welbertdeoliveira/Detector-de-condutividade-termica--TCD--para-cromatografia-a-gas/Diagramas mecanicos/DIAGRAMA BASICO.pptx

AMOSTRA

INJETOR

GÁS DE REFERÊNCIA

GÁS DE
ARRASTE

TCD

DESCARTE

SINAL

COLUNA

FORNO

FONTE DE GÁS

= Áreas aquecidas.

## Slide 2

PID

ATUADOR

FORNO

TEMPERATURA
DESEJADA

+

TEMPERATURA
AJUSTADA

SENSOR

SET POINT

VALOR
DESEJADO

AÇÃO P

ATUADOR

VARIAVEL
MANIPULADA

PROCESSO

VARIAVEL DE
PROCESSO

+

ERRO

AÇÃO I

+

+

+

VALOR
AJUSTADO

AÇÃO D

SENSOR
