welbertdeoliveira/Detector-de-condutividade-termica--TCD--para-cromatografia-a-gas/Fotos/20191212_202534.jpg

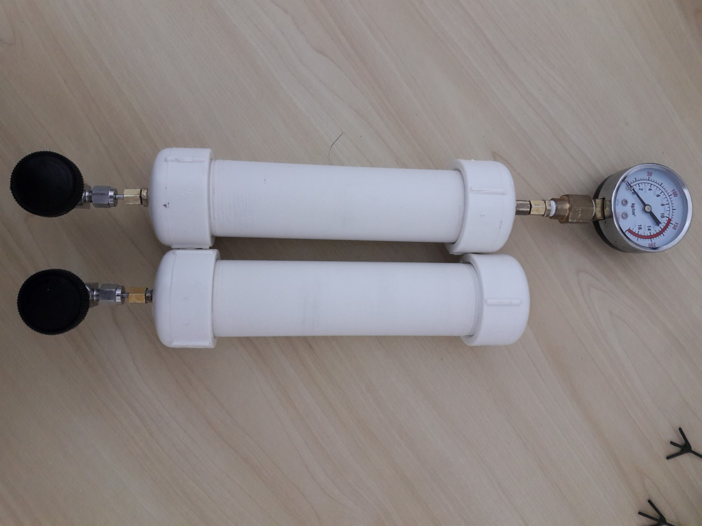
Fotos/20191212_202534.jpg
