welbertdeoliveira/Detector-de-condutividade-termica--TCD--para-cromatografia-a-gas/Fotos/20200205_210533.jpg

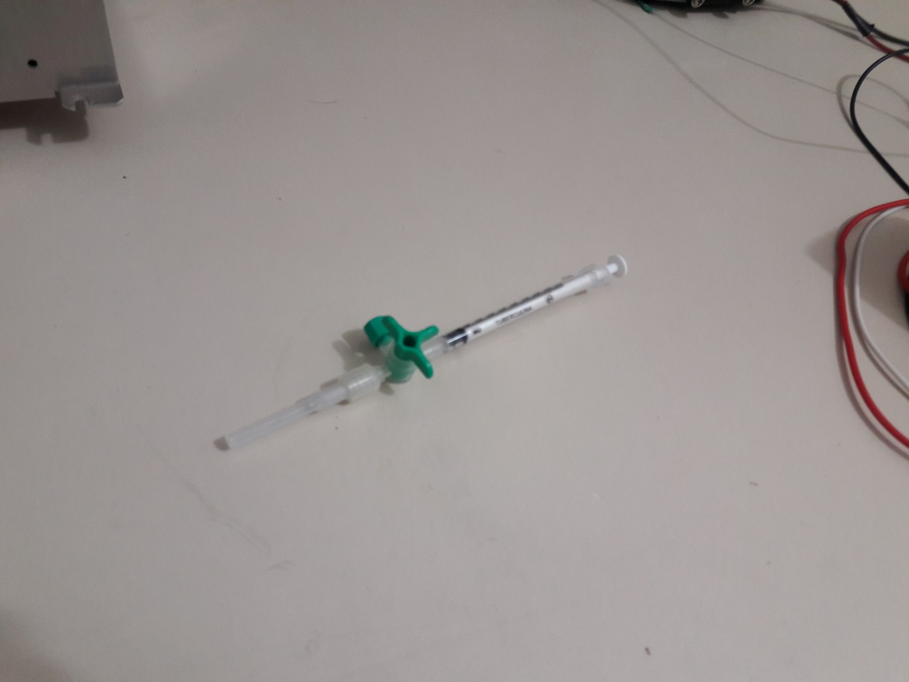
Fotos/20200205_210533.jpg
