welbertdeoliveira/Detector-de-condutividade-termica--TCD--para-cromatografia-a-gas/Fotos/20200209_221522.jpg

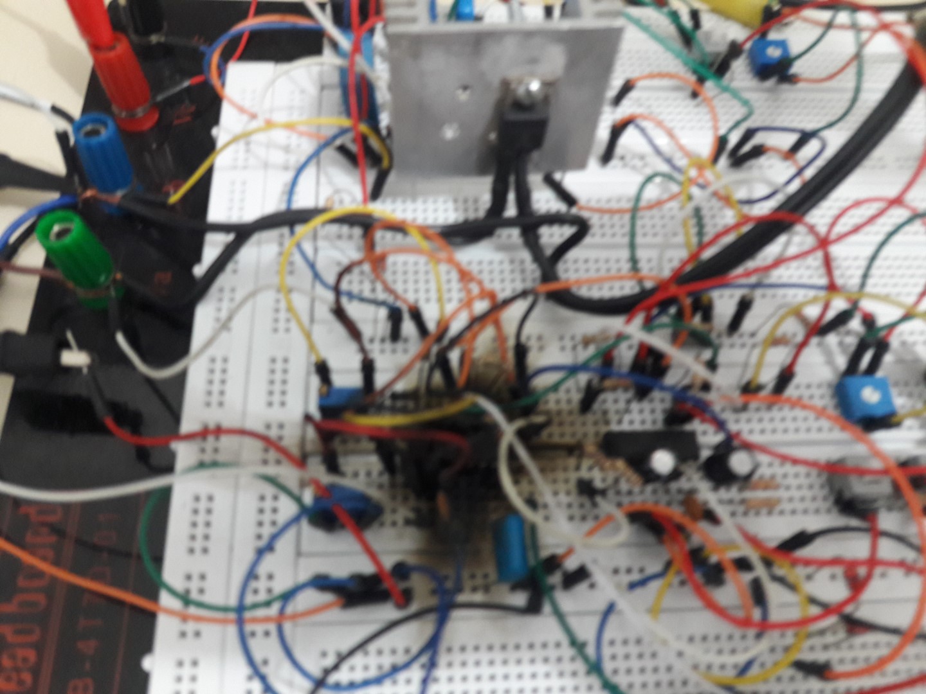
Fotos/20200209_221522.jpg
