welbertdeoliveira/Detector-de-condutividade-termica--TCD--para-cromatografia-a-gas/Fotos/20200209_230001.jpg

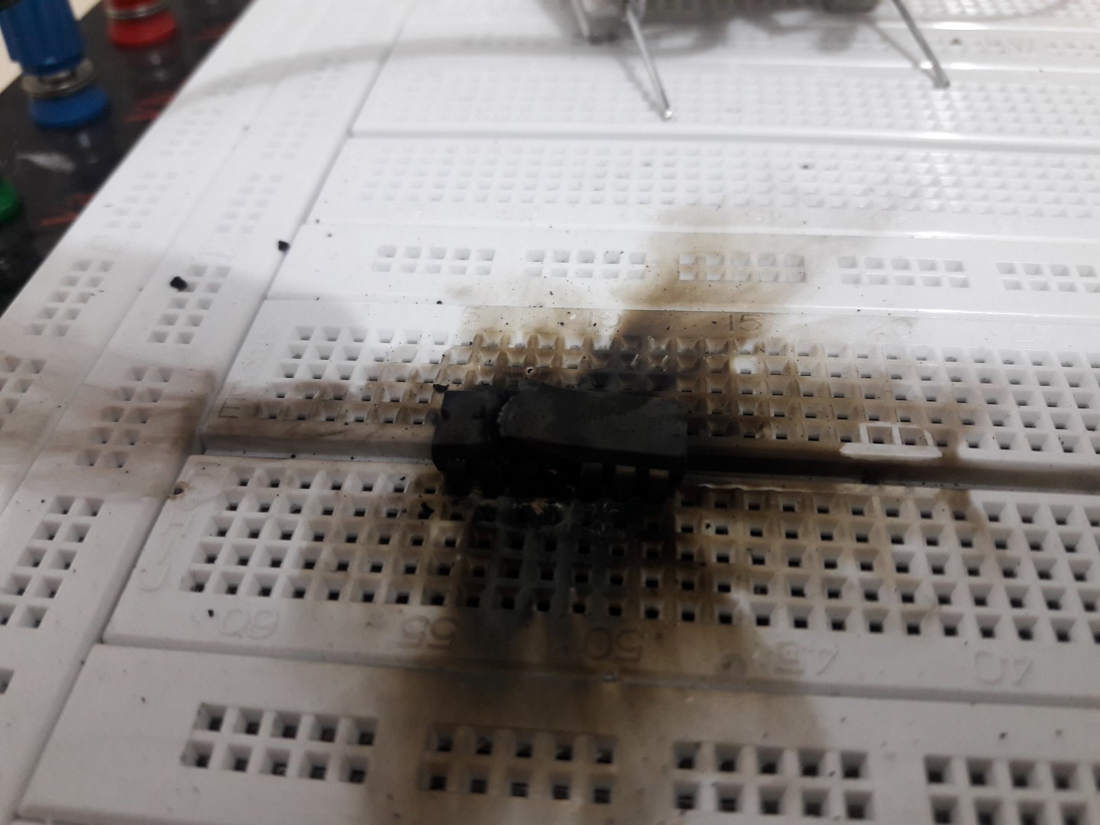
Fotos/20200209_230001.jpg
