welbertdeoliveira/Detector-de-condutividade-termica--TCD--para-cromatografia-a-gas/Fotos/20200210_165037.jpg

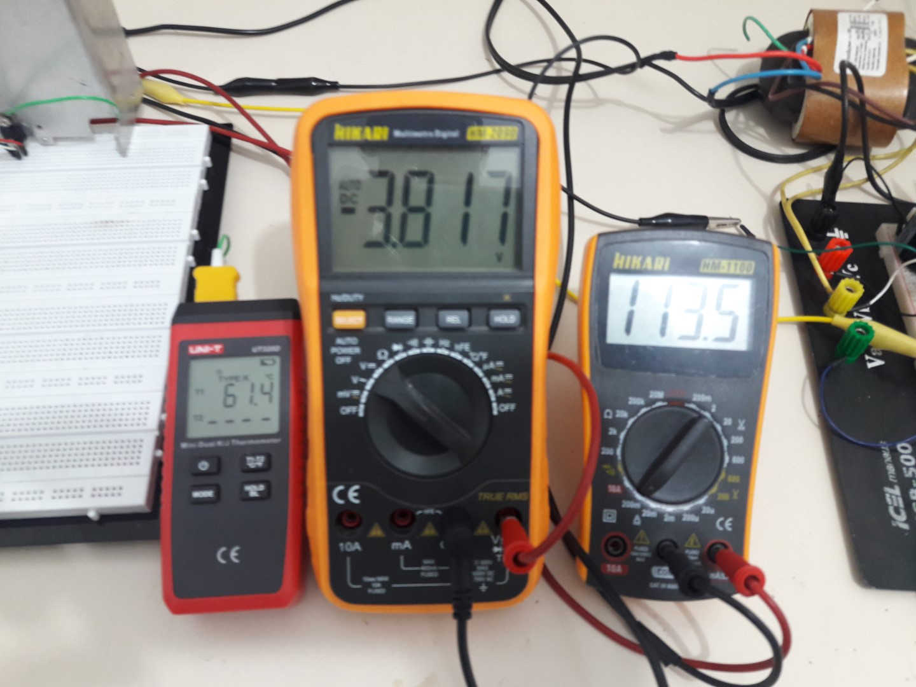
Fotos/20200210_165037.jpg
