welbertdeoliveira/Detector-de-condutividade-termica--TCD--para-cromatografia-a-gas/Fotos/20200210_211105.jpg

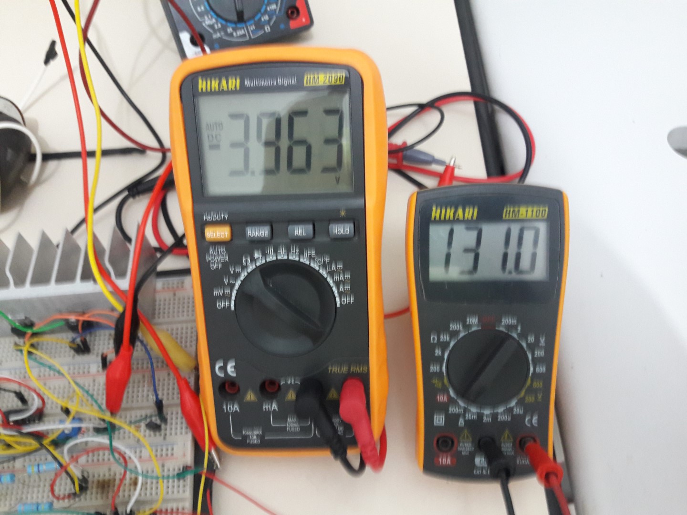
Fotos/20200210_211105.jpg
