welbertdeoliveira/Detector-de-condutividade-termica--TCD--para-cromatografia-a-gas/Fotos/20200210_211108.jpg

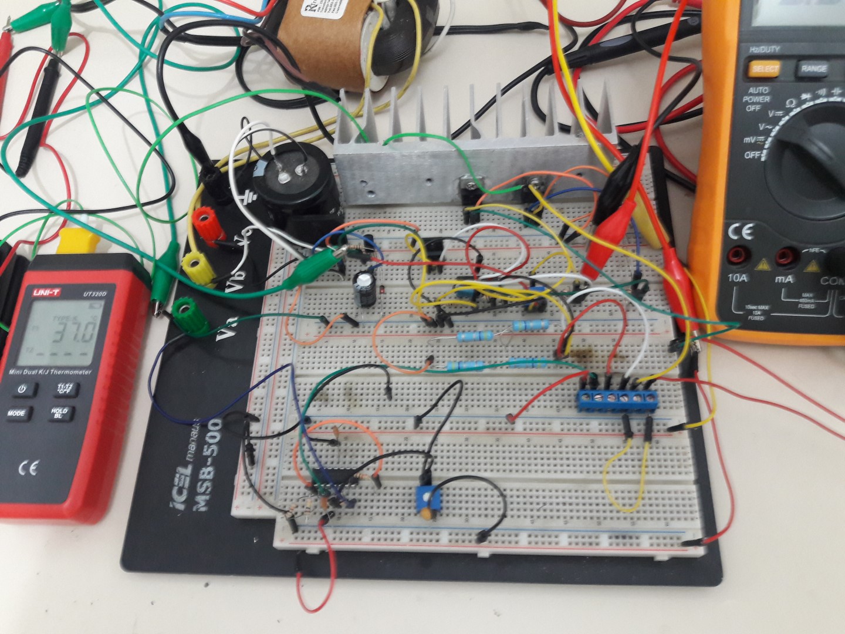
Fotos/20200210_211108.jpg
