welbertdeoliveira/Detector-de-condutividade-termica--TCD--para-cromatografia-a-gas/Fotos/20200213_203528.jpg

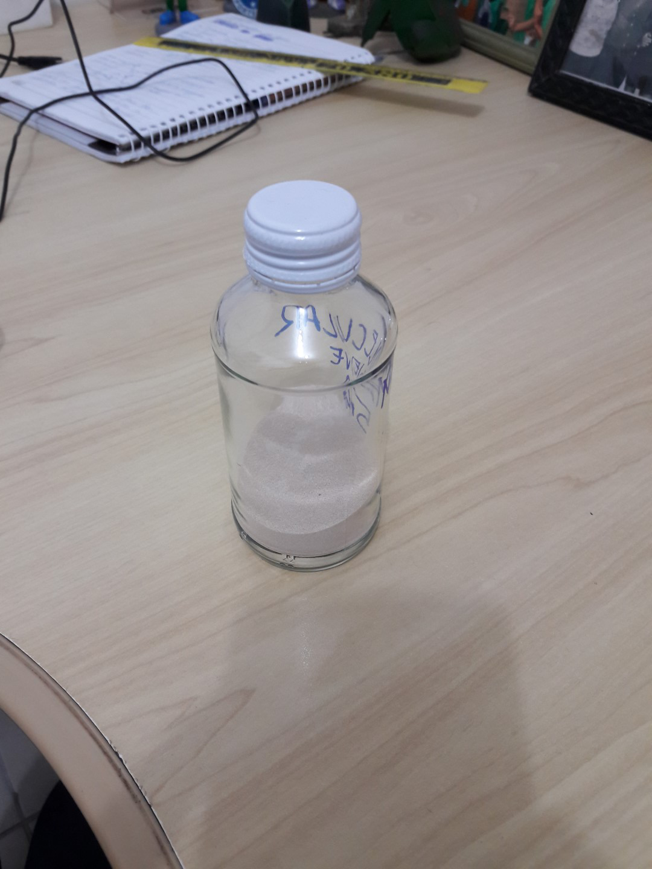
Fotos/20200213_203528.jpg
