welbertdeoliveira/Detector-de-condutividade-termica--TCD--para-cromatografia-a-gas/Fotos/20200216_193552.jpg

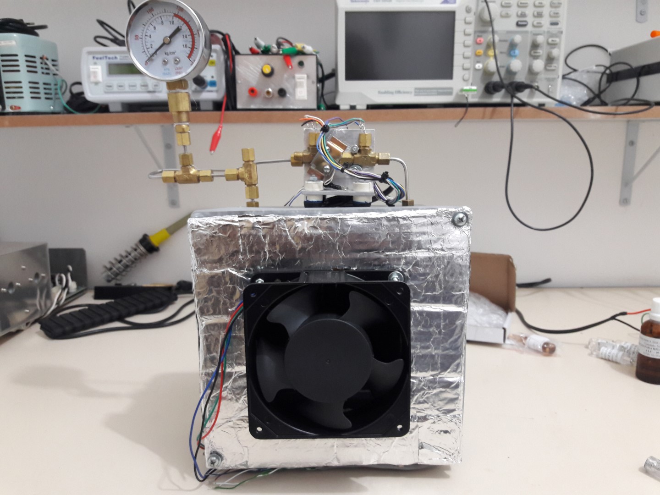
Fotos/20200216_193552.jpg
