welbertdeoliveira/Detector-de-condutividade-termica--TCD--para-cromatografia-a-gas/Fotos/20200216_193612.jpg

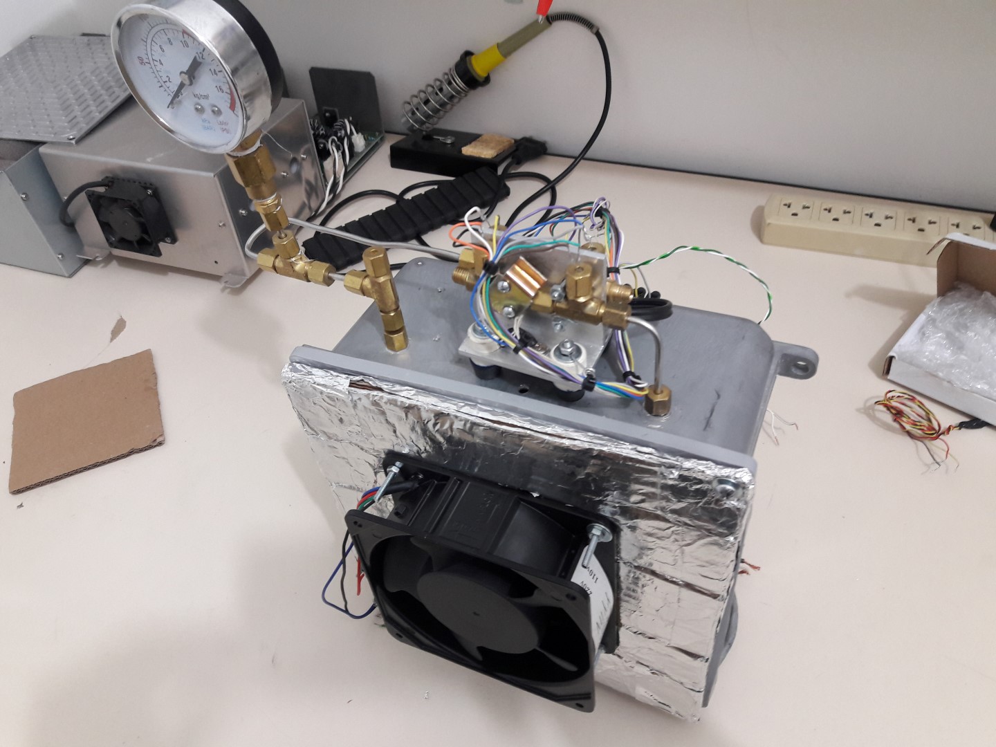
Fotos/20200216_193612.jpg
