welbertdeoliveira/Detector-de-condutividade-termica--TCD--para-cromatografia-a-gas/Fotos/Celula impressa/20200526_104427.jpg

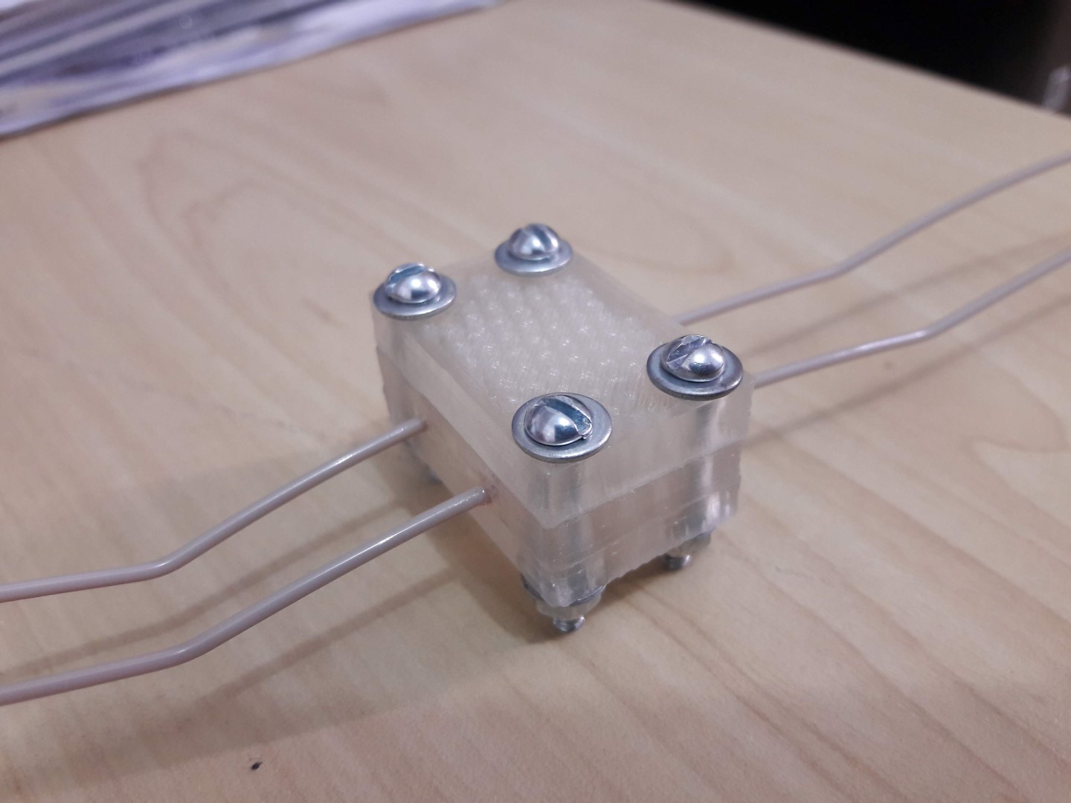
Fotos/Celula impressa/20200526_104427.jpg
