welbertdeoliveira/Detector-de-condutividade-termica--TCD--para-cromatografia-a-gas/Fotos/Célula nova/20191121_211144.jpg

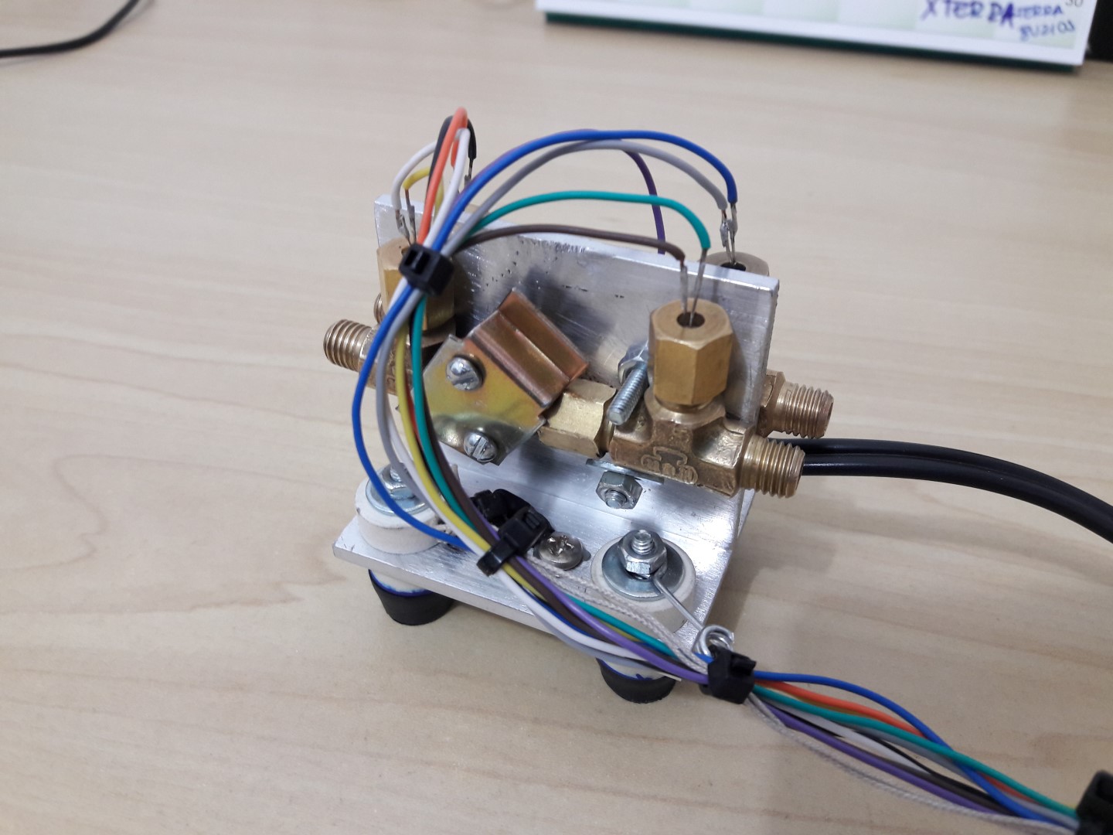
Fotos/Célula nova/20191121_211144.jpg
