welbertdeoliveira/Detector-de-condutividade-termica--TCD--para-cromatografia-a-gas/Fotos/Célula nova/20191121_211309.jpg

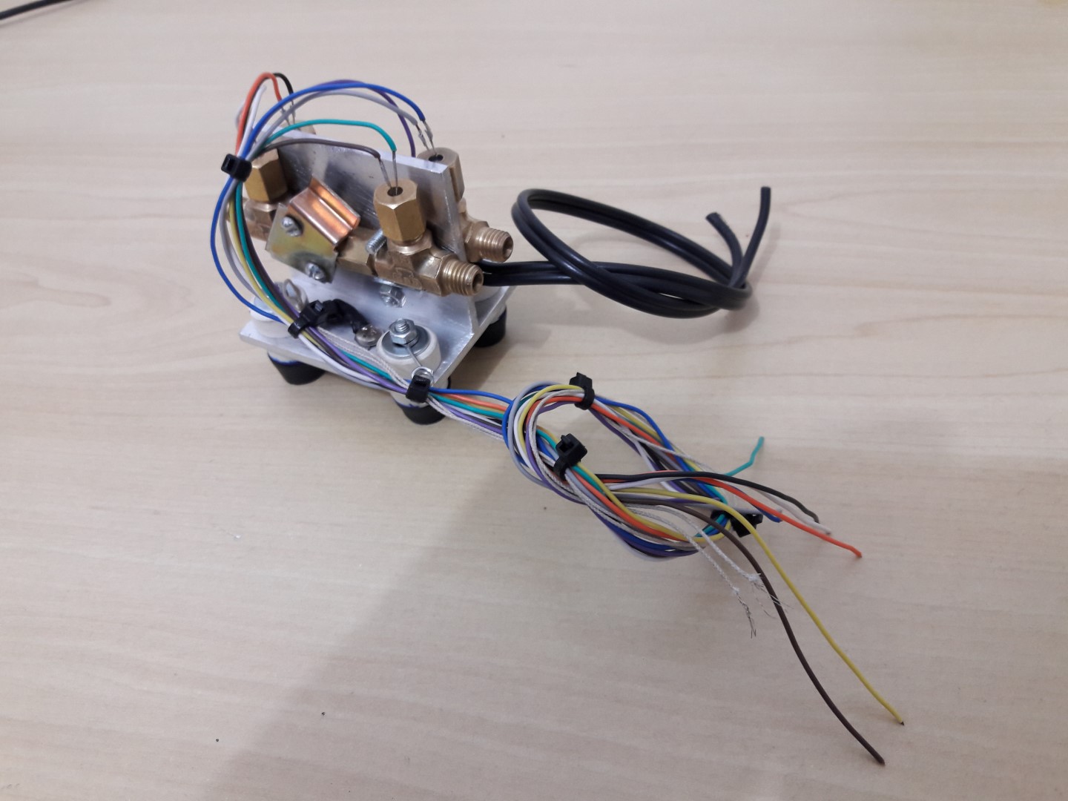
Fotos/Célula nova/20191121_211309.jpg
