welbertdeoliveira/Detector-de-condutividade-termica--TCD--para-cromatografia-a-gas/Fotos/Empacotamento coluna/20190920_161611.jpg

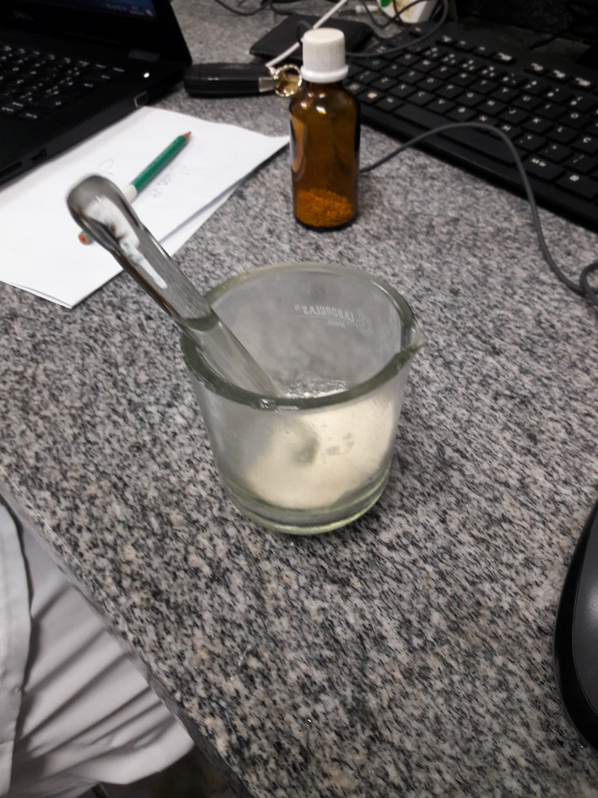
Fotos/Empacotamento coluna/20190920_161611.jpg
