welbertdeoliveira/Detector-de-condutividade-termica--TCD--para-cromatografia-a-gas/Fotos/Empacotamento coluna/20190920_161622.jpg

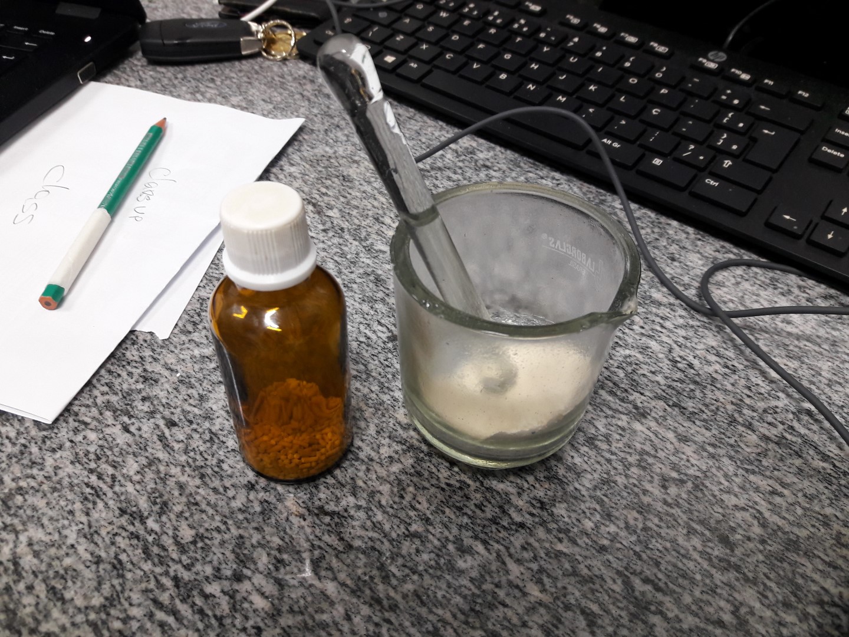
Fotos/Empacotamento coluna/20190920_161622.jpg
