welbertdeoliveira/Detector-de-condutividade-termica--TCD--para-cromatografia-a-gas/Fotos/Empacotamento coluna/20191207_102354.jpg

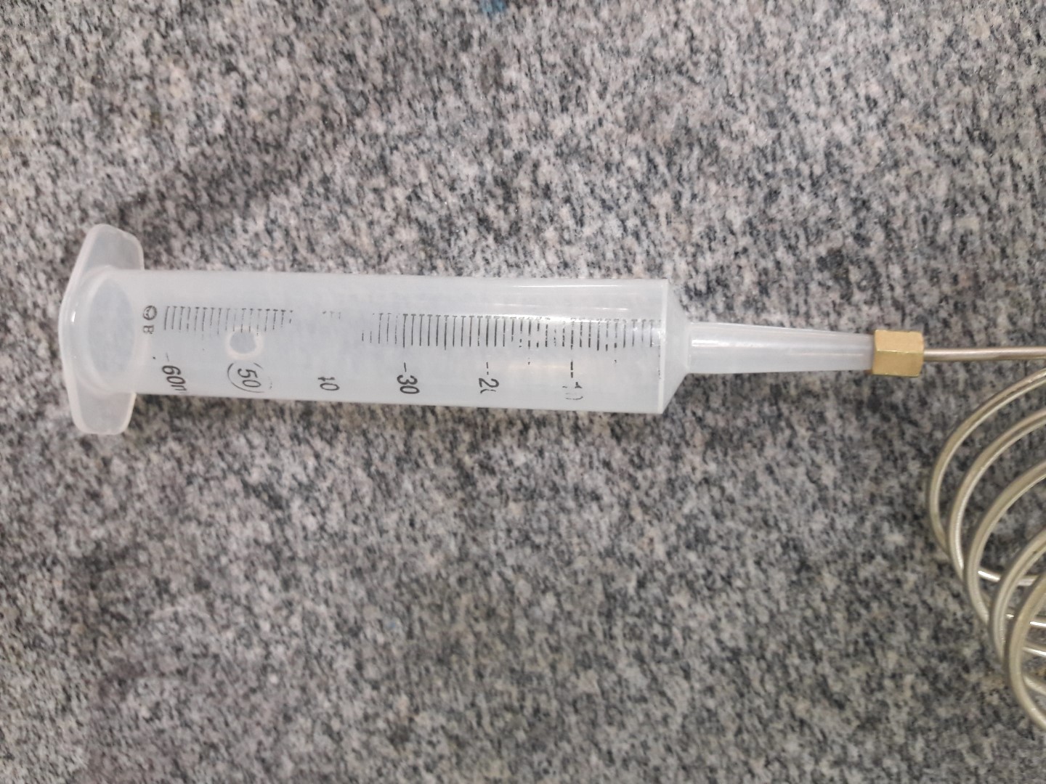
Fotos/Empacotamento coluna/20191207_102354.jpg
