welbertdeoliveira/Detector-de-condutividade-termica--TCD--para-cromatografia-a-gas/Fotos/Empacotamento coluna/IMG-20191015-WA0035.jpg

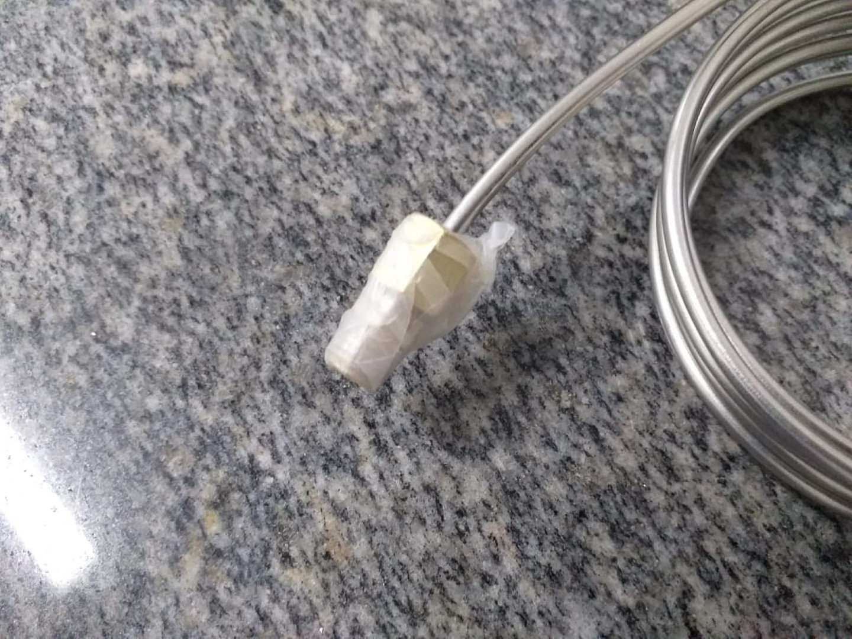
Fotos/Empacotamento coluna/IMG-20191015-WA0035.jpg
