welbertdeoliveira/Detector-de-condutividade-termica--TCD--para-cromatografia-a-gas/Fotos/Sistema completo/20190527_234842.jpg

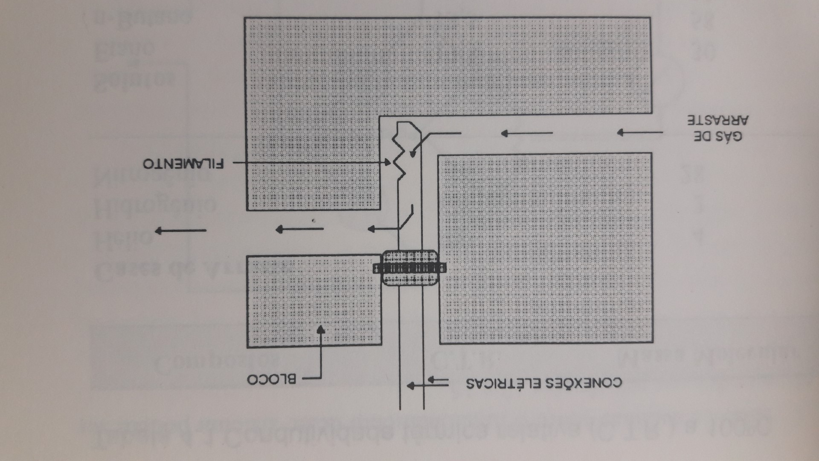
Fotos/Sistema completo/20190527_234842.jpg
