welbertdeoliveira/Detector-de-condutividade-termica--TCD--para-cromatografia-a-gas/Fotos/Sistema completo/20190619_135527.jpg

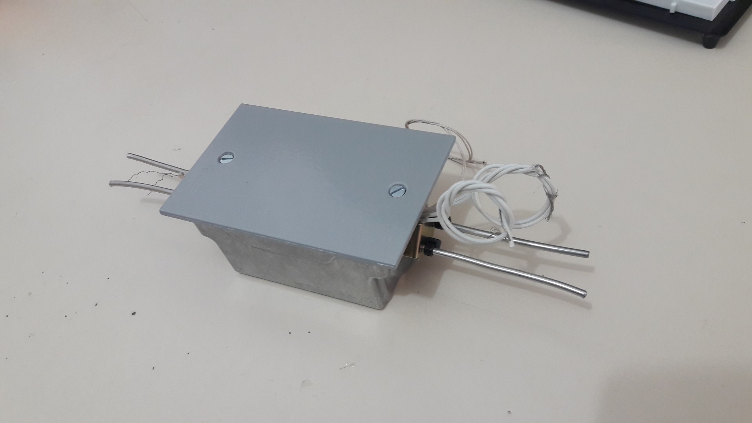
Fotos/Sistema completo/20190619_135527.jpg
