welbertdeoliveira/Detector-de-condutividade-termica--TCD--para-cromatografia-a-gas/Fotos/Sistema completo/20190909_160852.jpg

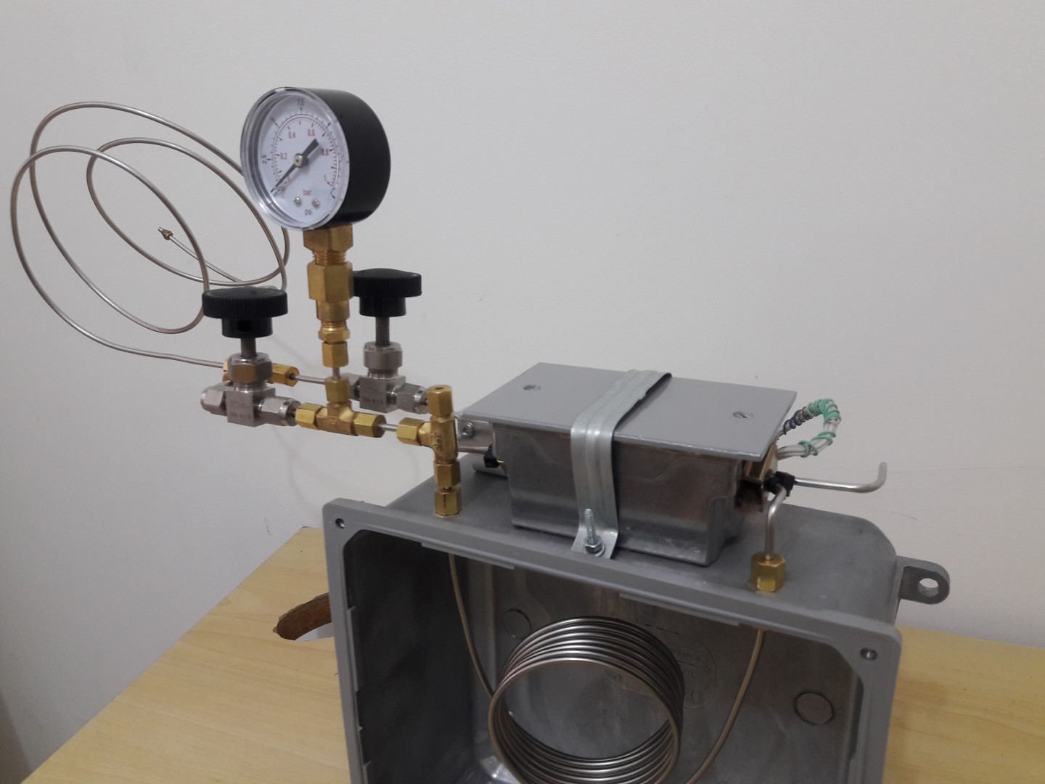
Fotos/Sistema completo/20190909_160852.jpg
