welbertdeoliveira/Detector-de-condutividade-termica--TCD--para-cromatografia-a-gas/Fotos/Sistema completo/20190909_160914.jpg

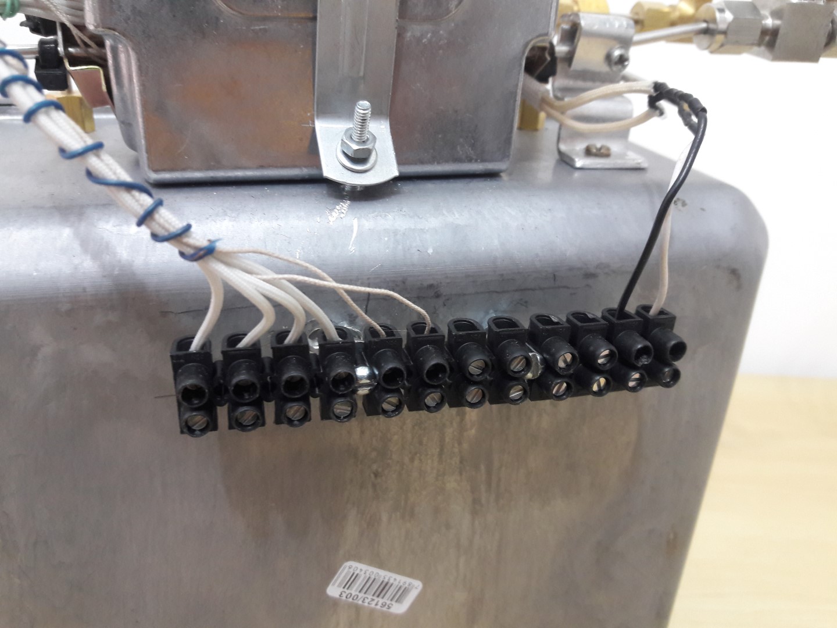
Fotos/Sistema completo/20190909_160914.jpg
