welbertdeoliveira/Detector-de-condutividade-termica--TCD--para-cromatografia-a-gas/Fotos/Sistema completo/20190909_193104.jpg

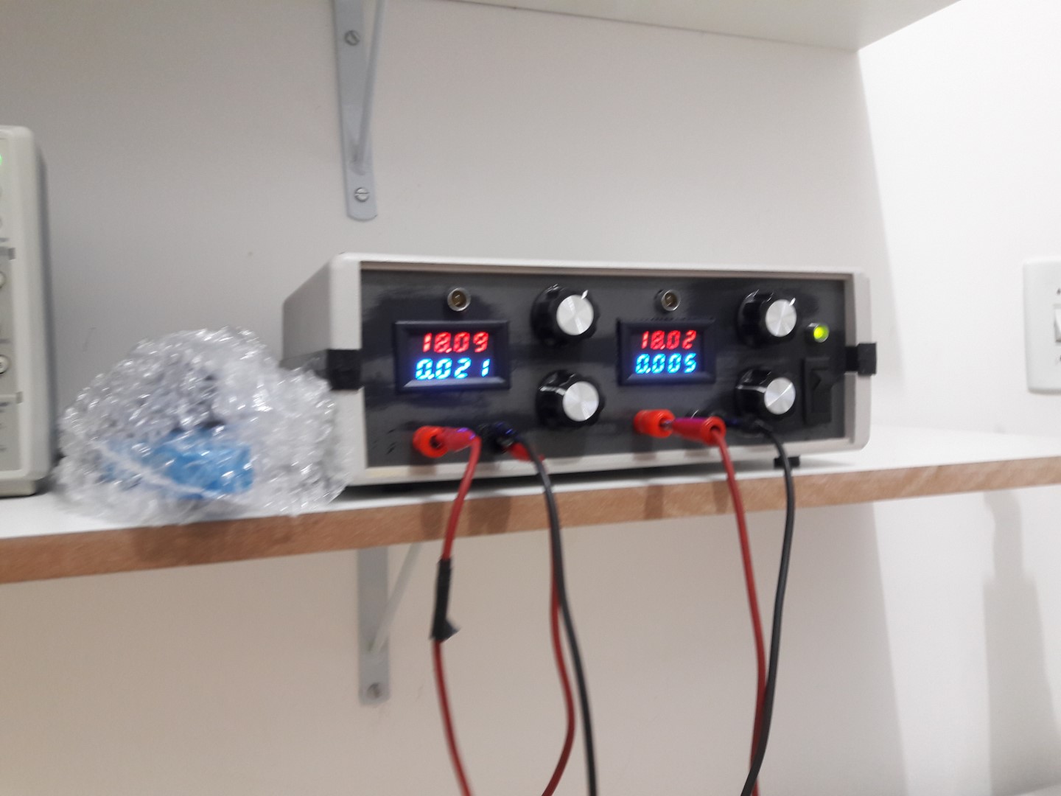
Fotos/Sistema completo/20190909_193104.jpg
