welbertdeoliveira/Detector-de-condutividade-termica--TCD--para-cromatografia-a-gas/Fotos/Sistema completo/20190909_193112.jpg

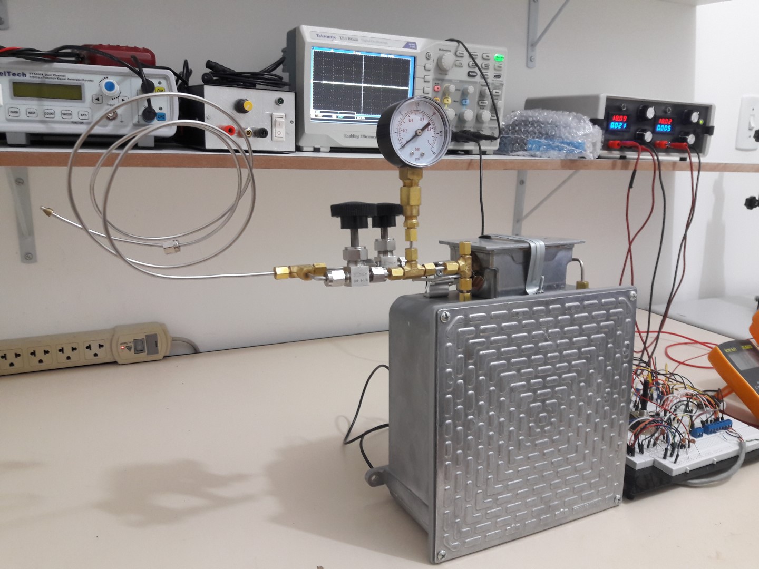
Fotos/Sistema completo/20190909_193112.jpg
