welbertdeoliveira/Detector-de-condutividade-termica--TCD--para-cromatografia-a-gas/Fotos/Sistema completo/20190912_141838.jpg

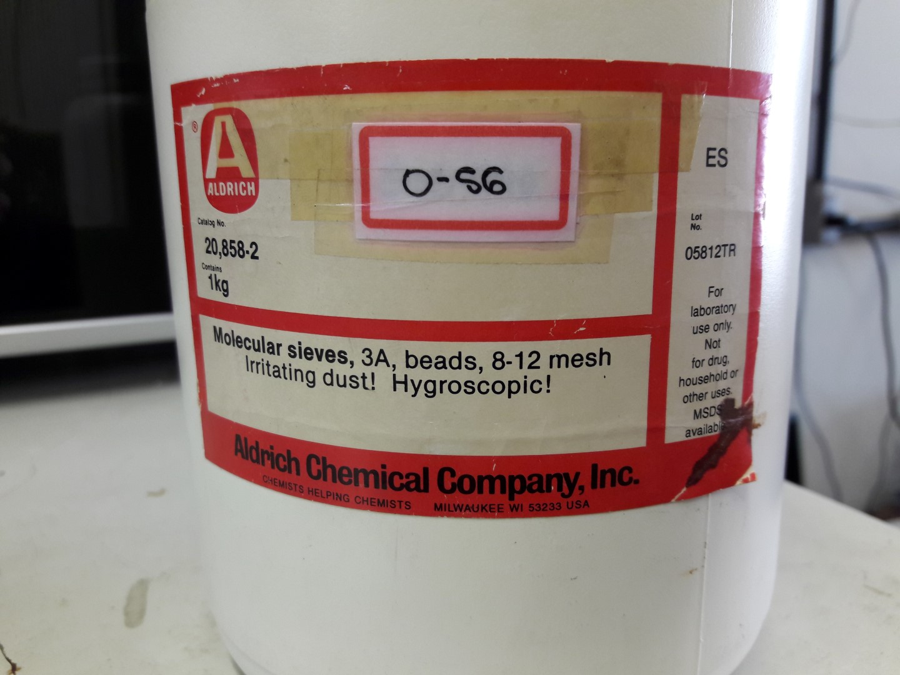
Fotos/Sistema completo/20190912_141838.jpg
