welbertdeoliveira/Detector-de-condutividade-termica--TCD--para-cromatografia-a-gas/Fotos/Sistema completo/20191016_161224.jpg

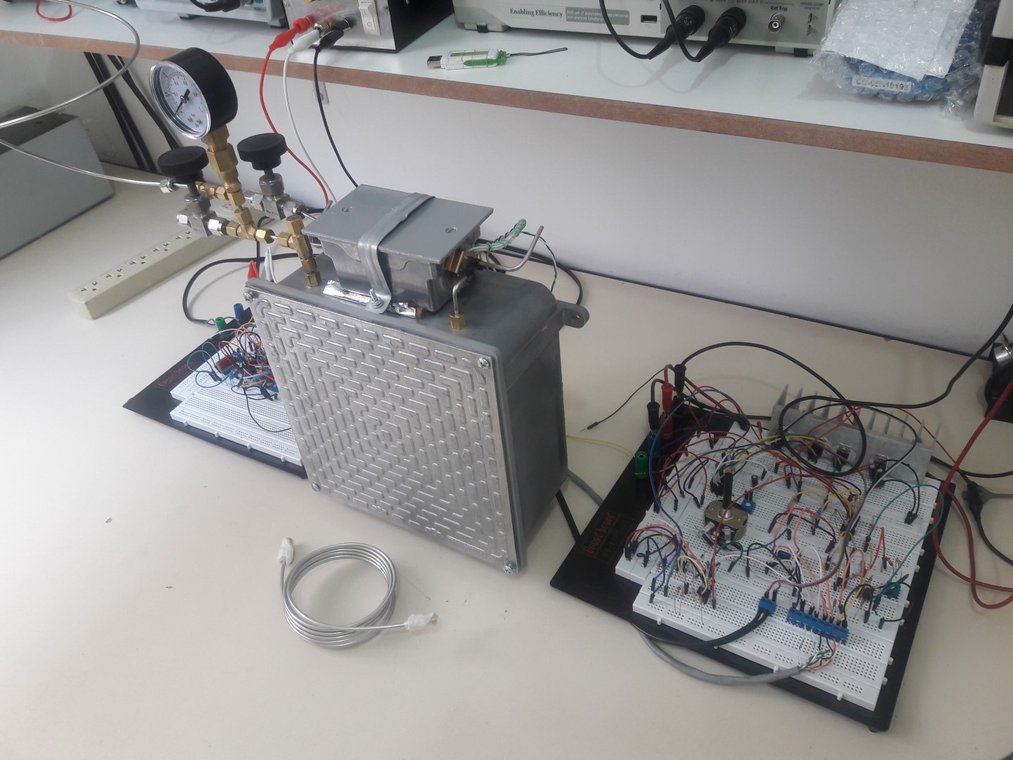
Fotos/Sistema completo/20191016_161224.jpg
