welbertdeoliveira/Detector-de-condutividade-termica--TCD--para-cromatografia-a-gas/Fotos/Sistema completo/20191018_010500.jpg

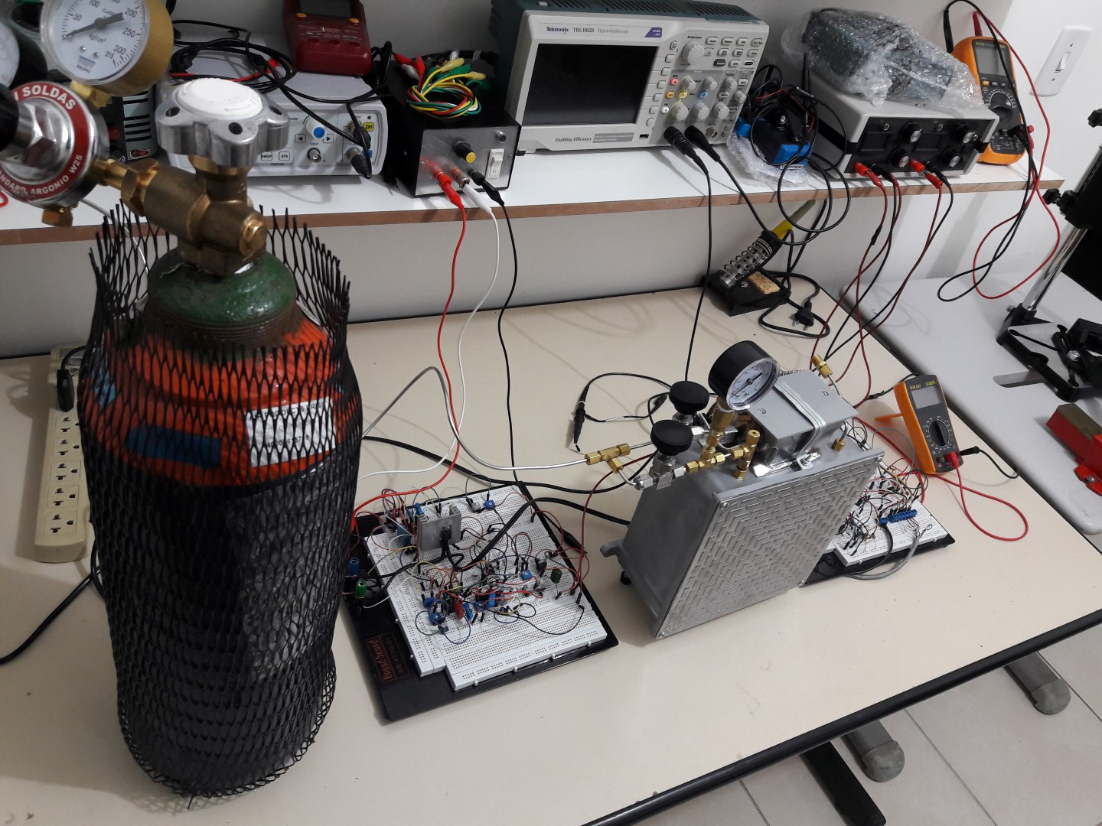
Fotos/Sistema completo/20191018_010500.jpg
