welbertdeoliveira/Detector-de-condutividade-termica--TCD--para-cromatografia-a-gas/Fotos/Componentes célula/20190528_203844.jpg

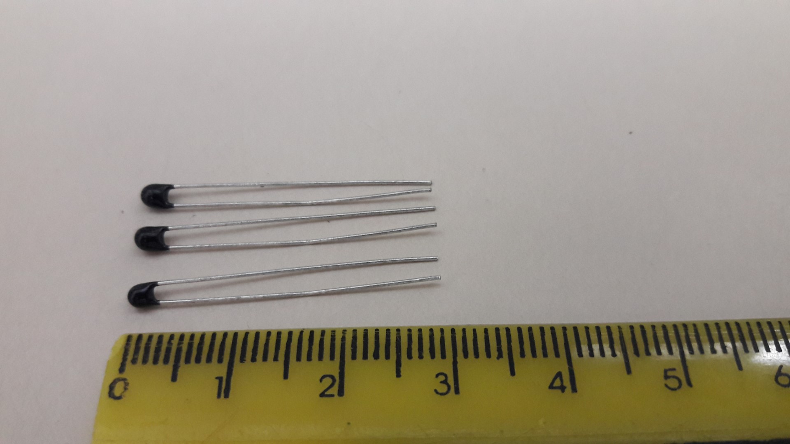
Fotos/Componentes célula/20190528_203844.jpg
