welbertdeoliveira/Detector-de-condutividade-termica--TCD--para-cromatografia-a-gas/Fotos/Componentes célula/20190528_203935.jpg

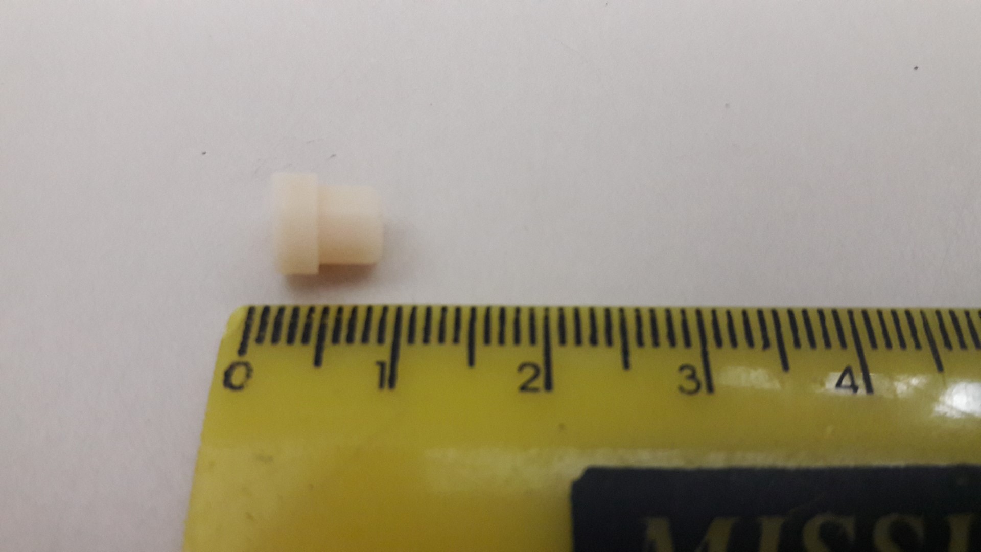
Fotos/Componentes célula/20190528_203935.jpg
