welbertdeoliveira/Detector-de-condutividade-termica--TCD--para-cromatografia-a-gas/Fotos/Montagem circuito/20190529_093619.jpg

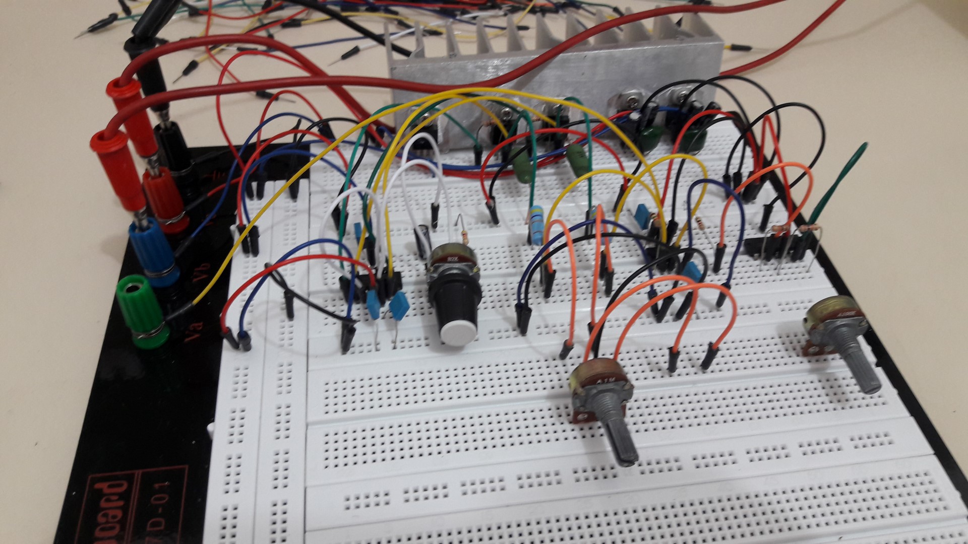
Fotos/Montagem circuito/20190529_093619.jpg
