welbertdeoliveira/Detector-de-condutividade-termica--TCD--para-cromatografia-a-gas/Fotos/Montagem circuito/20191006_094127.jpg

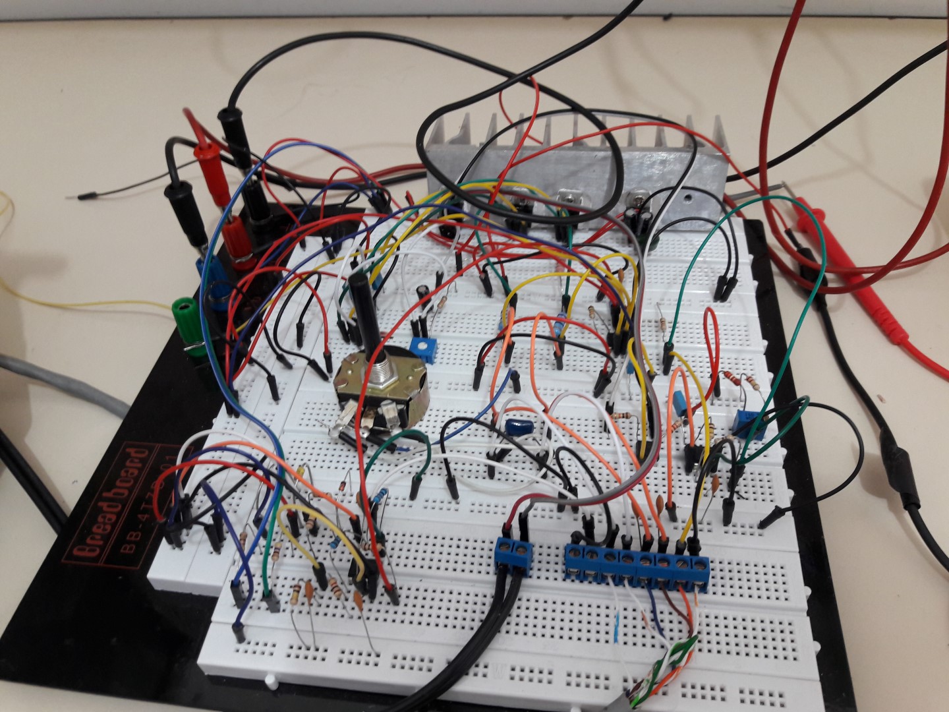
Fotos/Montagem circuito/20191006_094127.jpg
