welbertdeoliveira/Detector-de-condutividade-termica--TCD--para-cromatografia-a-gas/Fotos/Montagem circuito/20191006_133444.jpg

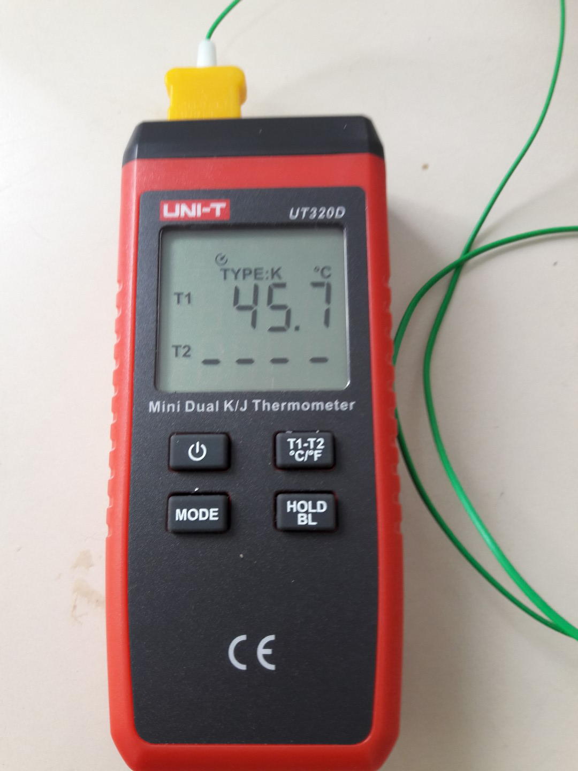
Fotos/Montagem circuito/20191006_133444.jpg
