welbertdeoliveira/Detector-de-condutividade-termica--TCD--para-cromatografia-a-gas/Fotos/Montagem de célula/20190528_210122.jpg

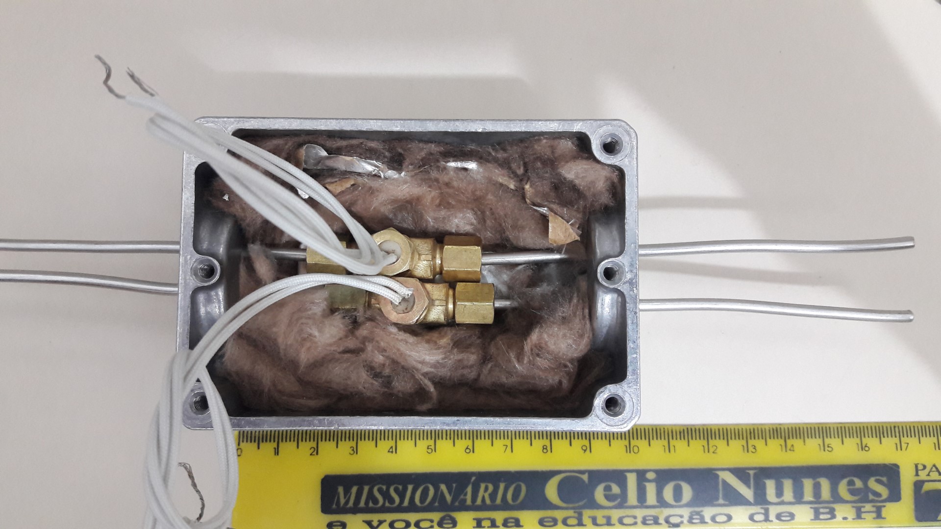
Fotos/Montagem de célula/20190528_210122.jpg
