welbertdeoliveira/Detector-de-condutividade-termica--TCD--para-cromatografia-a-gas/Fotos/Montagem de célula/20190528_212100.jpg

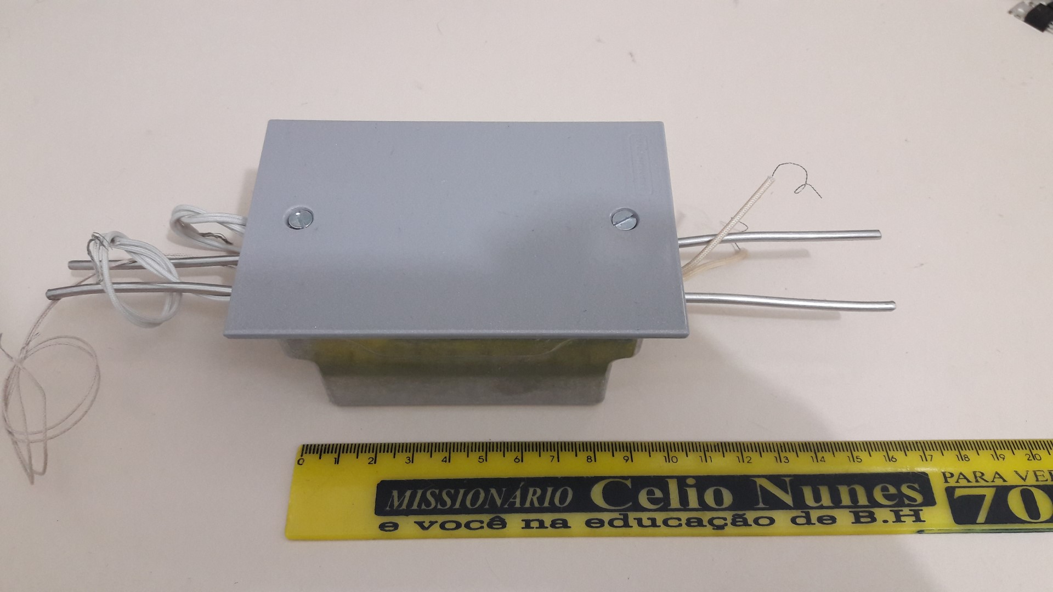
Fotos/Montagem de célula/20190528_212100.jpg
