welbertdeoliveira/Detector-de-condutividade-termica--TCD--para-cromatografia-a-gas/Primeiro experimento sistema completo/Primeiro experimento.xlsx

Record Length | 2500 | 0.000 | 1.460
Sample Interval | 0.1 | 0.100 | 1.460
Trigger Point | 0 | 0.200 | 1.460
 |  | 0.300 | 1.460
 |  | 0.400 | 1.460
 |  | 0.500 | 1.460
Source | CH1 | 0.600 | 1.460
Vertical Units | V | 0.700 | 1.460
Vertical Scale | 0.5 | 0.800 | 1.460
Vertical Offset | -4.02 | 0.900 | 1.460
Horizontal Units | s | 1.000 | 1.460
Horizontal Scale | 25 | 1.100 | 1.460
Pt Fmt | Y | 1.200 | 1.460
Yzero | 0 | 1.300 | 1.460
Probe Atten | 10 | 1.400 | 1.460
Model Number | TBS1052B | 1.500 | 1.460
Serial Number | C014253 | 1.600 | 1.460
Firmware Version | FV:v2.52 | 1.700 | 1.460
 |  | 1.800 | 1.460
 |  | 1.900 | 1.460
 |  | 2.000 | 1.460
 |  | 2.100 | 1.460
 |  | 2.200 | 1.460
 |  | 2.300 | 1.460
 |  | 2.400 | 1.460
 |  | 2.500 | 1.460
 |  | 2.600 | 1.460
 |  | 2.700 | 1.460
 |  | 2.800 | 1.460
 |  | 2.900 | 1.460
 |  | 3.000 | 1.460
 |  | 3.100 | 1.460
 |  | 3.200 | 1.460
 |  | 3.300 | 1.460
 |  | 3.400 | 1.460
 |  | 3.500 | 1.460
 |  | 3.600 | 1.460
 |  | 3.700 | 1.460
 |  | 3.800 | 1.460
 |  | 3.900 | 1.460
 |  | 4.000 | 1.460
 |  | 4.100 | 1.460
 |  | 4.200 | 1.460
 |  | 4.300 | 1.460
 |  | 4.400 | 1.460
 |  | 4.500 | 1.460
 |  | 4.600 | 1.460
 |  | 4.700 | 1.460
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
