welbertdeoliveira/Detector-de-condutividade-termica--TCD--para-cromatografia-a-gas/Segundo experimento sistema completo/Pasta1.xlsx

Record Length | 2500 | 17.000 | -2.120 | 0.000 | 0.000
Sample Interval | 0.2 | 17.200 | -2.120 | 0.200 | 0.000
Trigger Point | 0 | 17.400 | -2.100 | 0.400 | 0.020
 |  | 17.600 | -2.120 | 0.600 | 0.000
 |  | 17.800 | -2.100 | 0.800 | 0.020
 |  | 18.000 | -2.120 | 1.000 | 0.000
Source | CH1 | 18.200 | -2.120 | 1.200 | 0.000
Vertical Units | V | 18.400 | -2.100 | 1.400 | 0.020
Vertical Scale | 0.5 | 18.600 | -2.100 | 1.600 | 0.020
Vertical Offset | 0.64 | 18.800 | -2.100 | 1.800 | 0.020
Horizontal Units | s | 19.000 | -2.100 | 2.000 | 0.020
Horizontal Scale | 50 | 19.200 | -2.120 | 2.200 | 0.000
Pt Fmt | Y | 19.400 | -2.100 | 2.400 | 0.020
Yzero | 0 | 19.600 | -2.100 | 2.600 | 0.020
Probe Atten | 10 | 19.800 | -2.120 | 2.800 | 0.000
Model Number | TBS1052B | 20.000 | -2.100 | 3.000 | 0.020
Serial Number | C014253 | 20.200 | -2.100 | 3.200 | 0.020
Firmware Version | FV:v2.52 | 20.400 | -2.120 | 3.400 | 0.000
 |  | 20.600 | -2.100 | 3.600 | 0.020
 |  | 20.800 | -2.100 | 3.800 | 0.020
 |  | 21.000 | -2.100 | 4.000 | 0.020
 |  | 21.200 | -2.100 | 4.200 | 0.020
 |  | 21.400 | -2.100 | 4.400 | 0.020
 |  | 21.600 | -2.120 | 4.600 | 0.000
 |  | 21.800 | -2.120 | 4.800 | 0.000
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
