welbertdeoliveira/Detector-de-condutividade-termica--TCD--para-cromatografia-a-gas/Segundo experimento sistema completo/ALL0000/F0000CH1.CSV

Record Length | 2.500000e+03 | 0.000000000000 | -2.28000
Sample Interval | 1.000000e-01 | 0.100000000000 | -2.28000
Trigger Point | -0.000000000000e+00 | 0.200000000000 | -2.28000
 |  | 0.300000000000 | -2.32000
 |  | 0.400000000000 | -2.28000
 |  | 0.500000000000 | -2.28000
Source | CH1 | 0.600000000000 | -2.32000
Vertical Units | V | 0.700000000000 | -2.32000
Vertical Scale | 1.000000e+00 | 0.800000000000 | -2.32000
Vertical Offset | 1.200000e-01 | 0.900000000000 | -2.28000
Horizontal Units | s | 1.000000000000 | -2.28000
Horizontal Scale | 2.500000e+01 | 1.100000000000 | -2.32000
Pt Fmt | Y | 1.200000000000 | -2.28000
Yzero | 0.000000e+00 | 1.300000000000 | -2.32000
Probe Atten | 1.000000e+01 | 1.400000000000 | -2.32000
Model Number | TBS1052B | 1.500000000000 | -2.32000
Serial Number | C014253 | 1.600000000000 | -2.32000
Firmware Version | FV:v2.52 | 1.700000000000 | -2.32000
 |  | 1.800000000000 | -2.32000
 |  | 1.900000000000 | -2.32000
 |  | 2.000000000000 | -2.32000
 |  | 2.100000000000 | -2.32000
 |  | 2.200000000000 | -2.32000
 |  | 2.300000000000 | -2.32000
 |  | 2.400000000000 | -2.32000
 |  | 2.500000000000 | -2.32000
 |  | 2.600000000000 | -2.32000
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
