welbertdeoliveira/Detector-de-condutividade-termica--TCD--para-cromatografia-a-gas/Segundo experimento sistema completo/ALL0002/F0002CH1.CSV

Record Length | 2.500000e+03 | 0.000000000000 | -3.20000
Sample Interval | 2.000000e-01 | 0.200000000000 | -3.20000
Trigger Point | -0.000000000000e+00 | 0.400000000000 | -3.20000
 |  | 0.600000000000 | -3.20000
 |  | 0.800000000000 | -3.20000
 |  | 1.000000000000 | -3.20000
Source | CH1 | 1.200000000000 | -3.20000
Vertical Units | V | 1.400000000000 | -3.20000
Vertical Scale | 5.000000e-01 | 1.600000000000 | -3.20000
Vertical Offset | 6.400000e-01 | 1.800000000000 | -3.20000
Horizontal Units | s | 2.000000000000 | -3.20000
Horizontal Scale | 5.000000e+01 | 2.200000000000 | -3.20000
Pt Fmt | Y | 2.400000000000 | -3.20000
Yzero | 0.000000e+00 | 2.600000000000 | -3.20000
Probe Atten | 1.000000e+01 | 2.800000000000 | -3.20000
Model Number | TBS1052B | 3.000000000000 | -3.20000
Serial Number | C014253 | 3.200000000000 | -3.20000
Firmware Version | FV:v2.52 | 3.400000000000 | -3.20000
 |  | 3.600000000000 | -3.20000
 |  | 3.800000000000 | -3.20000
 |  | 4.000000000000 | -3.20000
 |  | 4.200000000000 | -3.20000
 |  | 4.400000000000 | -3.20000
 |  | 4.600000000000 | -3.20000
 |  | 4.800000000000 | -3.20000
 |  | 5.000000000000 | -3.20000
 |  | 5.200000000000 | -3.20000
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
