welbertdeoliveira/Detector-de-condutividade-termica--TCD--para-cromatografia-a-gas/Fotos/Primeiro teste célula/20190528_212741.jpg

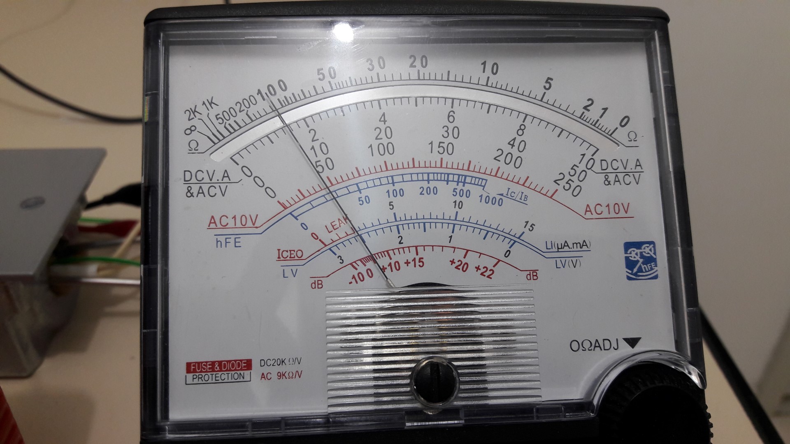
Fotos/Primeiro teste célula/20190528_212741.jpg
