welbertdeoliveira/Detector-de-condutividade-termica--TCD--para-cromatografia-a-gas/Fotos/Primeiro teste sistema/20191017_231946.jpg

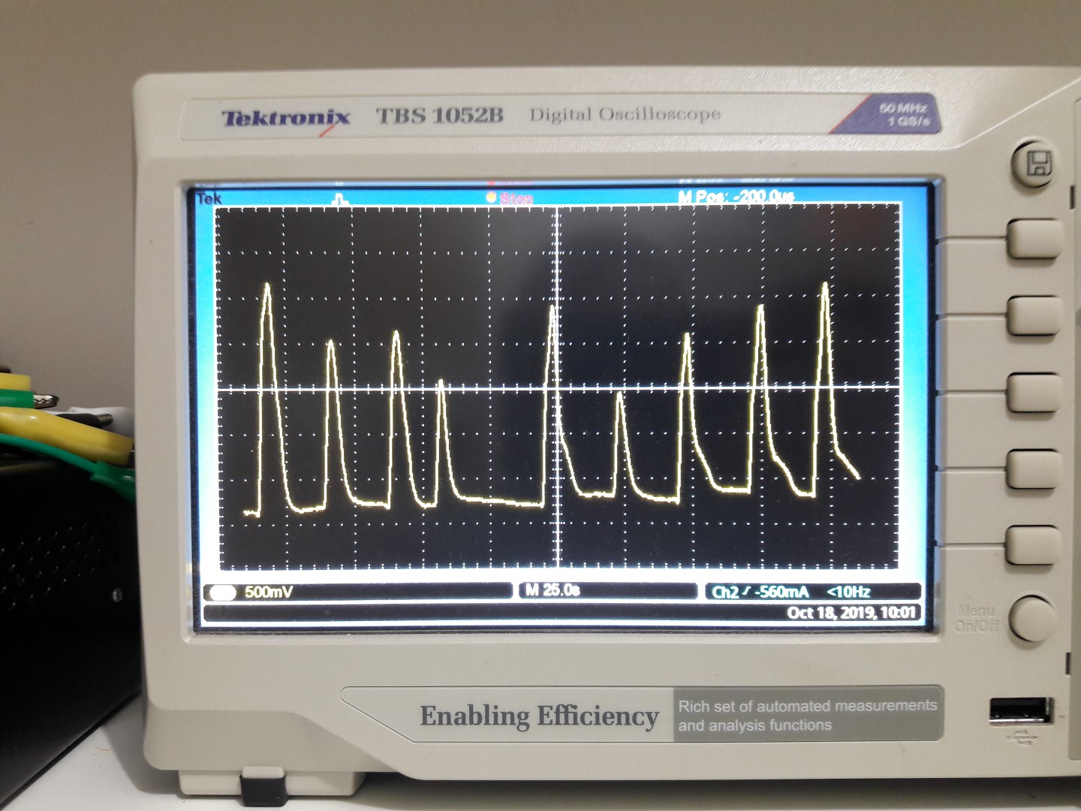
Fotos/Primeiro teste sistema/20191017_231946.jpg
