welbertdeoliveira/Detector-de-condutividade-termica--TCD--para-cromatografia-a-gas/Fotos/Testes aquecimento do corpo da celula/20190528_213323.jpg

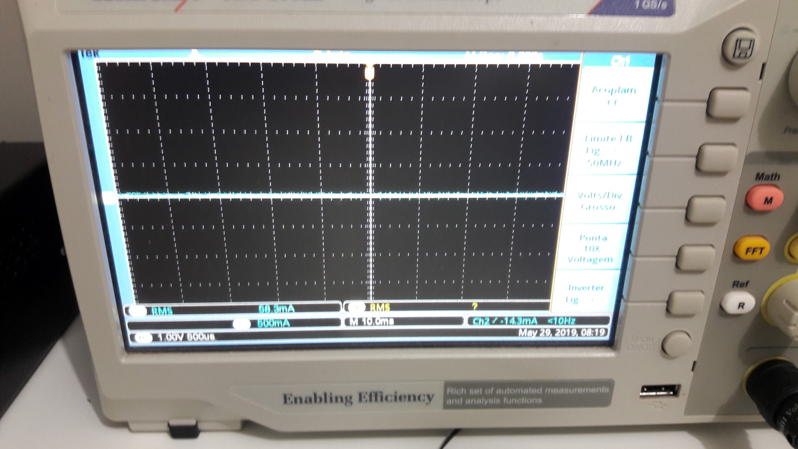
Fotos/Testes aquecimento do corpo da celula/20190528_213323.jpg
