welbertdeoliveira/Detector-de-condutividade-termica--TCD--para-cromatografia-a-gas/Fotos/Testes aquecimento do corpo da celula/20190528_213433.jpg

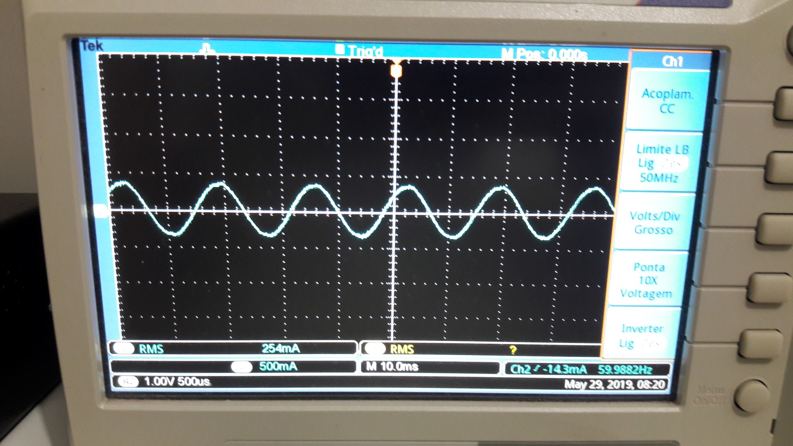
Fotos/Testes aquecimento do corpo da celula/20190528_213433.jpg
