welbertdeoliveira/Detector-de-condutividade-termica--TCD--para-cromatografia-a-gas/Fotos/Testes aquecimento do corpo da celula/20190614_134636.jpg

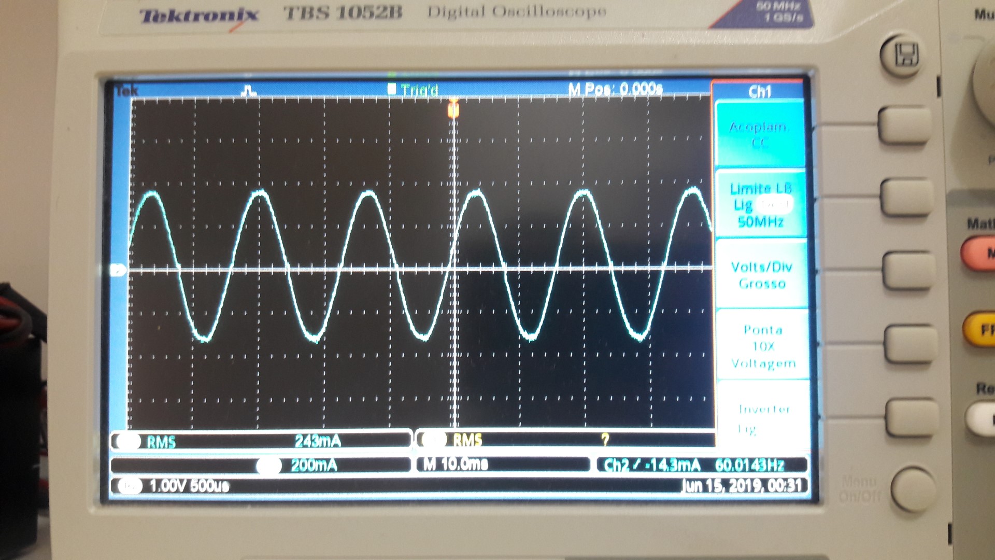
Fotos/Testes aquecimento do corpo da celula/20190614_134636.jpg
