welbertdeoliveira/Detector-de-condutividade-termica--TCD--para-cromatografia-a-gas/Diagramas eletrônicos/Controlador TCD (final).pdf

RV1

R2

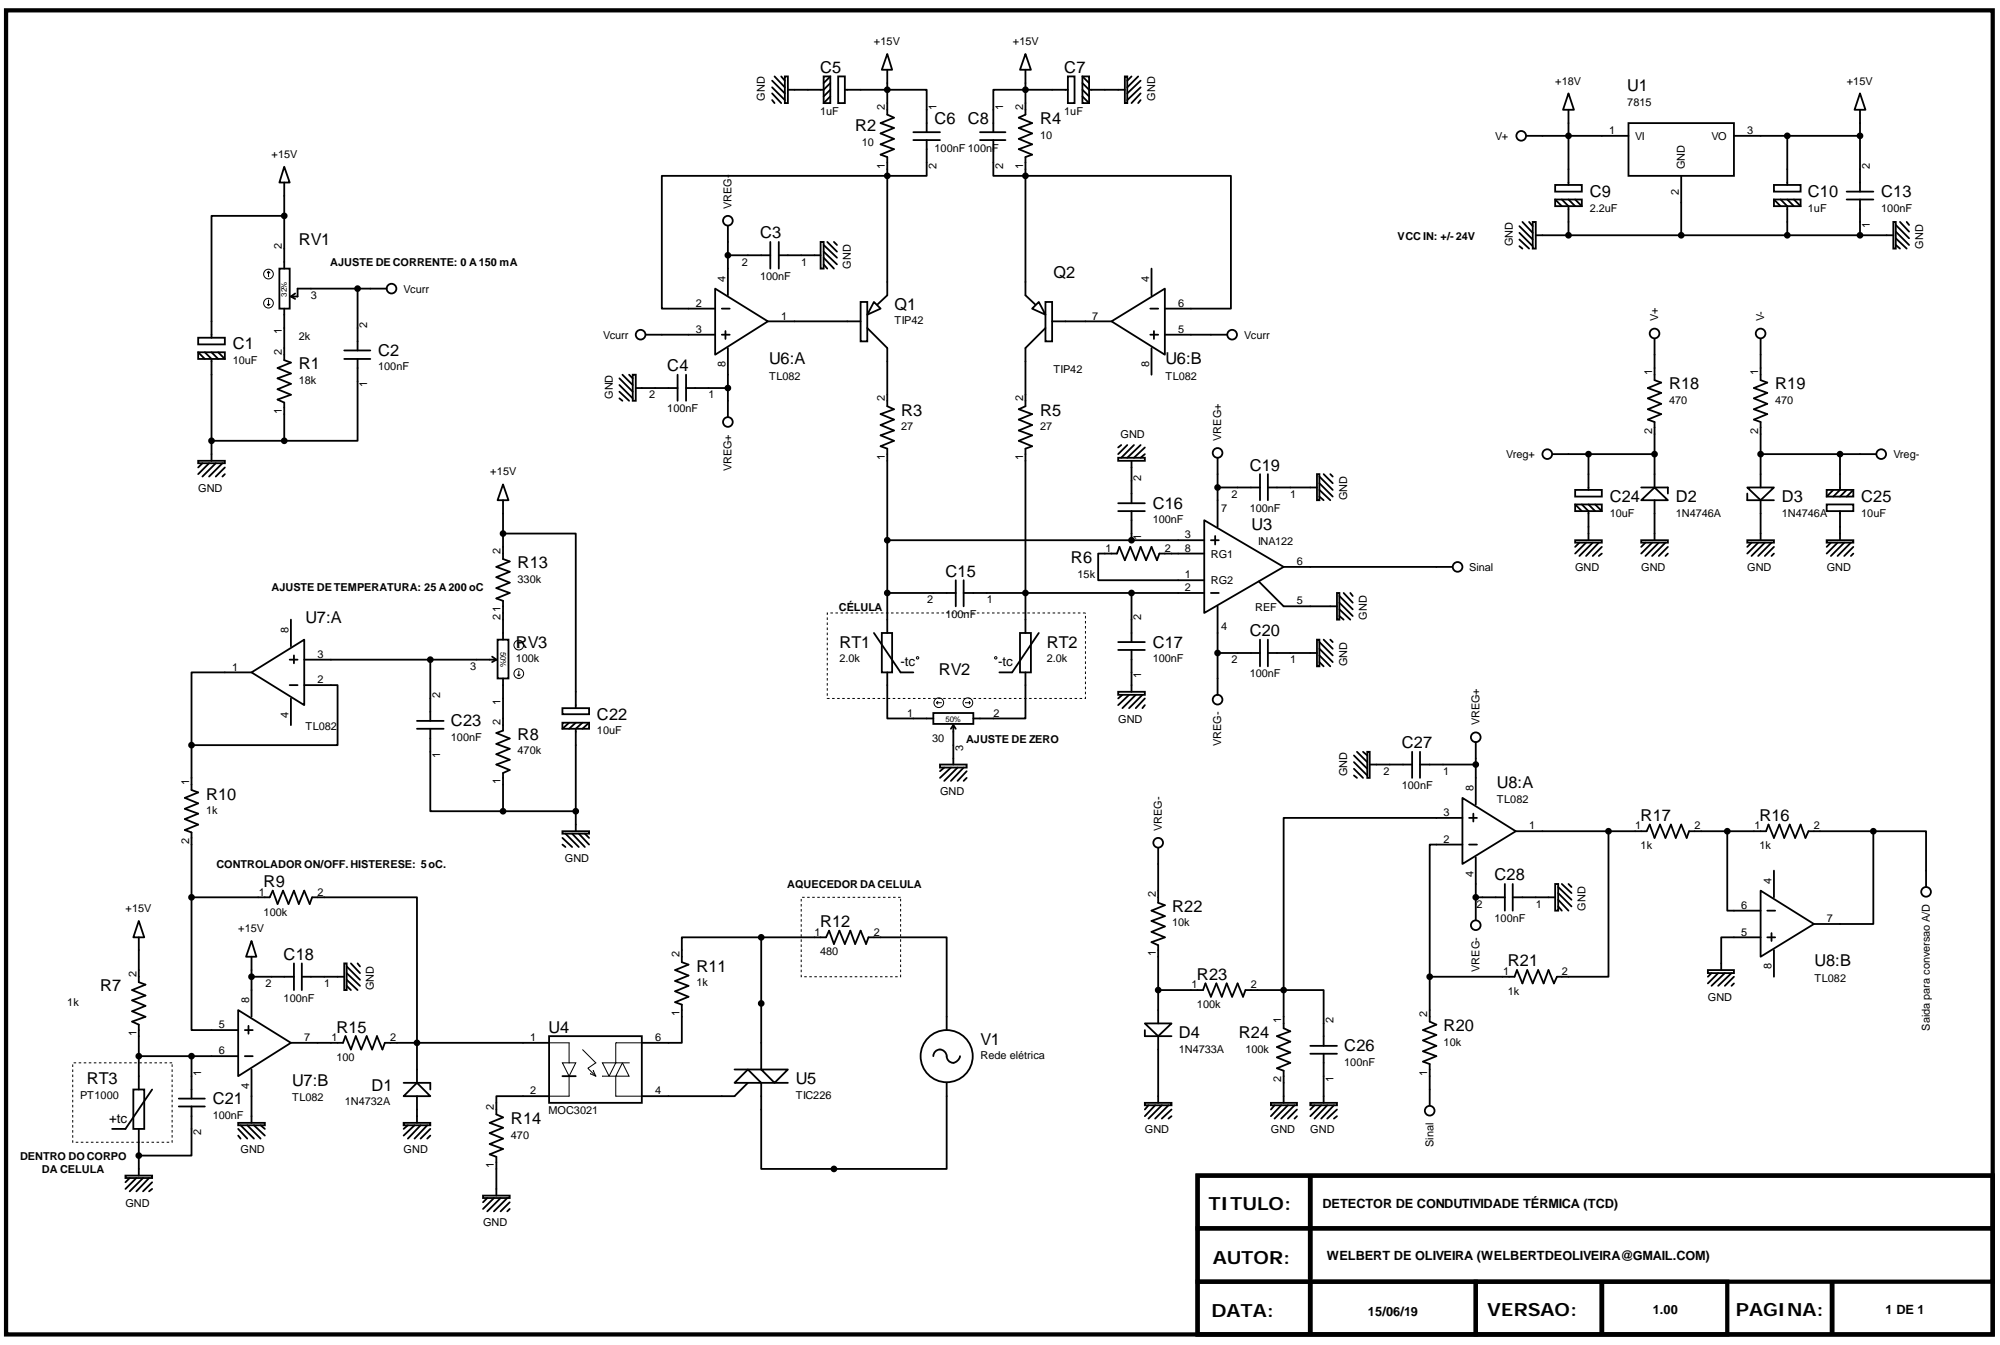
[picture p236: page 1]

AJUSTE DE CORRENTE: 0 A 150 mA

AJUSTE DE TEMPERATURA: 25 A 200 oC

CONTROLADOR ON/OFF. HISTERESE: 5 oC.

DETECTOR DE CONDUTIVIDADE TÉRMICA (TCD)

WELBERT DE OLIVEIRA (WELBERTDEOLIVEIRA@GMAIL.COM)
