welbertdeoliveira/Detector-de-condutividade-termica--TCD--para-cromatografia-a-gas/Diagramas eletrônicos/PID Forno (final).pdf

R1

R1

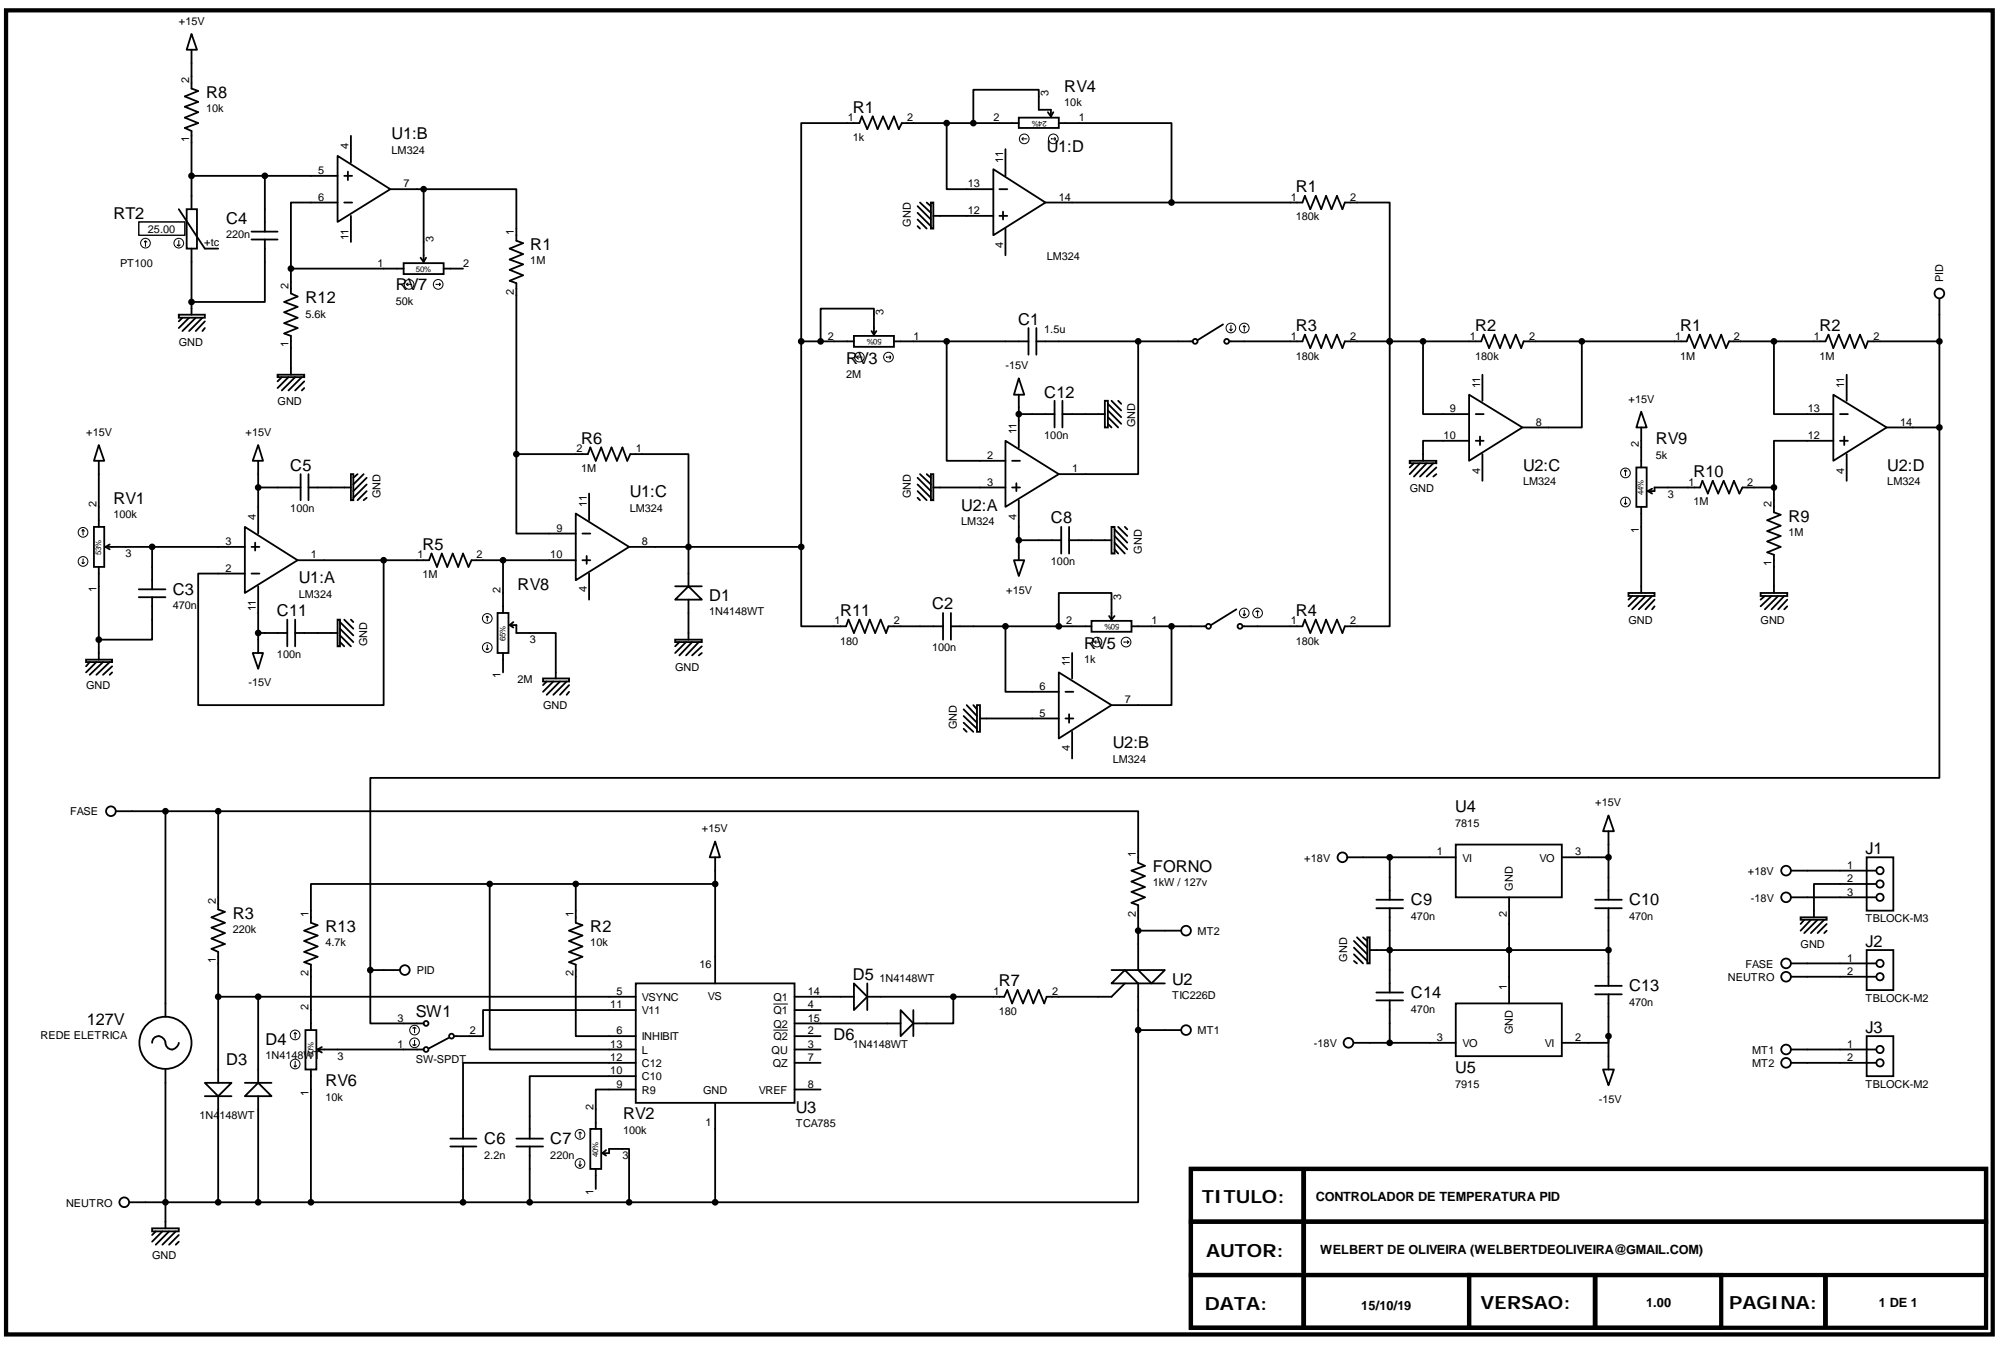
[picture p237: page 1]

CONTROLADOR DE TEMPERATURA PID

WELBERT DE OLIVEIRA (WELBERTDEOLIVEIRA@GMAIL.COM)
