welbertdeoliveira/Detector-de-condutividade-termica--TCD--para-cromatografia-a-gas/(list of files, drawings)

Other design files:
Diagramas eletrônicos/Celula.DSN
Diagramas eletrônicos/PID.DSN
Diagramas eletrônicos/PROTOTIPO FUNCIONAL (FINAL).DSN
